AnthMendoza/ActuatorSpeedController/speed controller/.step

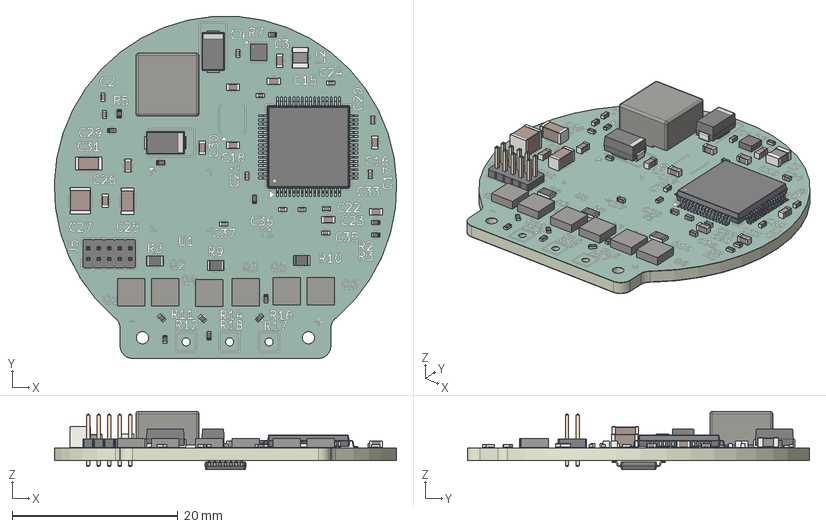
[picture p3: CAD file, 2026-11-07]
speed controller/.step
41.3 x 41.2 x 7.03 mm
C_0402_1005Metric x 13
C_1206_3216Metric x 2
C_0603_1608Metric x 10
R_0805_2012Metric x 3
WSON_8_1EP_2x2mm_P05mm_EP09x16mm
R_0402_1005Metric x 13
D_SMA x 2
L_1008_2520Metric
LQFP-64_10x10mm_P0.5mm
C_1210_3225Metric
PinHeader_2x05_P127mm_Vertical
TSSOP-14_4.4x5mm_P0.65mm
speed controller-unsaved-export-xcZnCC_silkscreen x 2
speed controller-unsaved-export-xcZnCC_soldermask x 2
speed controller-unsaved-export-xcZnCC_PCB
