AnthMendoza/ActuatorSpeedController/speed controller.pdf

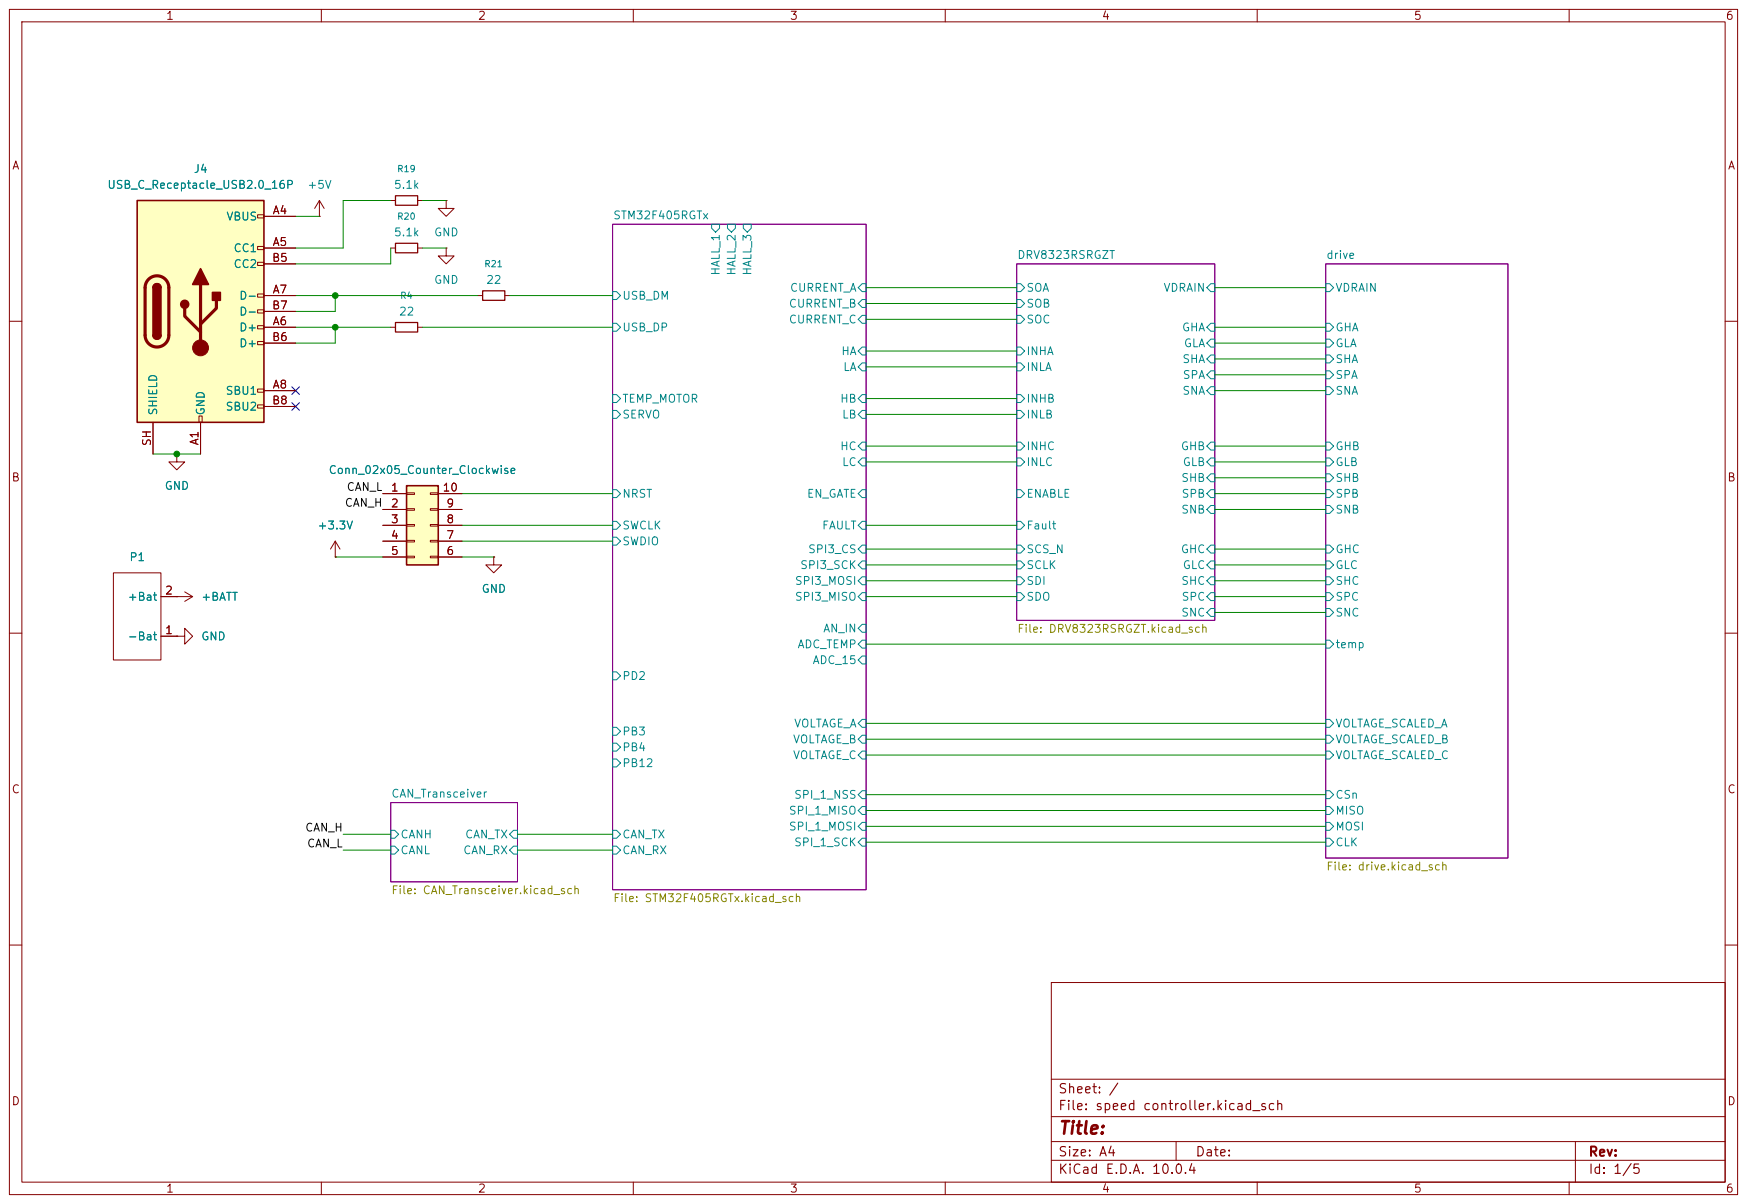
[picture p4: page 1]

VDRAIN
CSn MISO MOSI GHA GHB
GLA GLB
SHA SHB
SPA SPB
SNA SNB

Size: A4 | Rev:
KiCad E.D.A. 10.0.4 | Id: 1/5

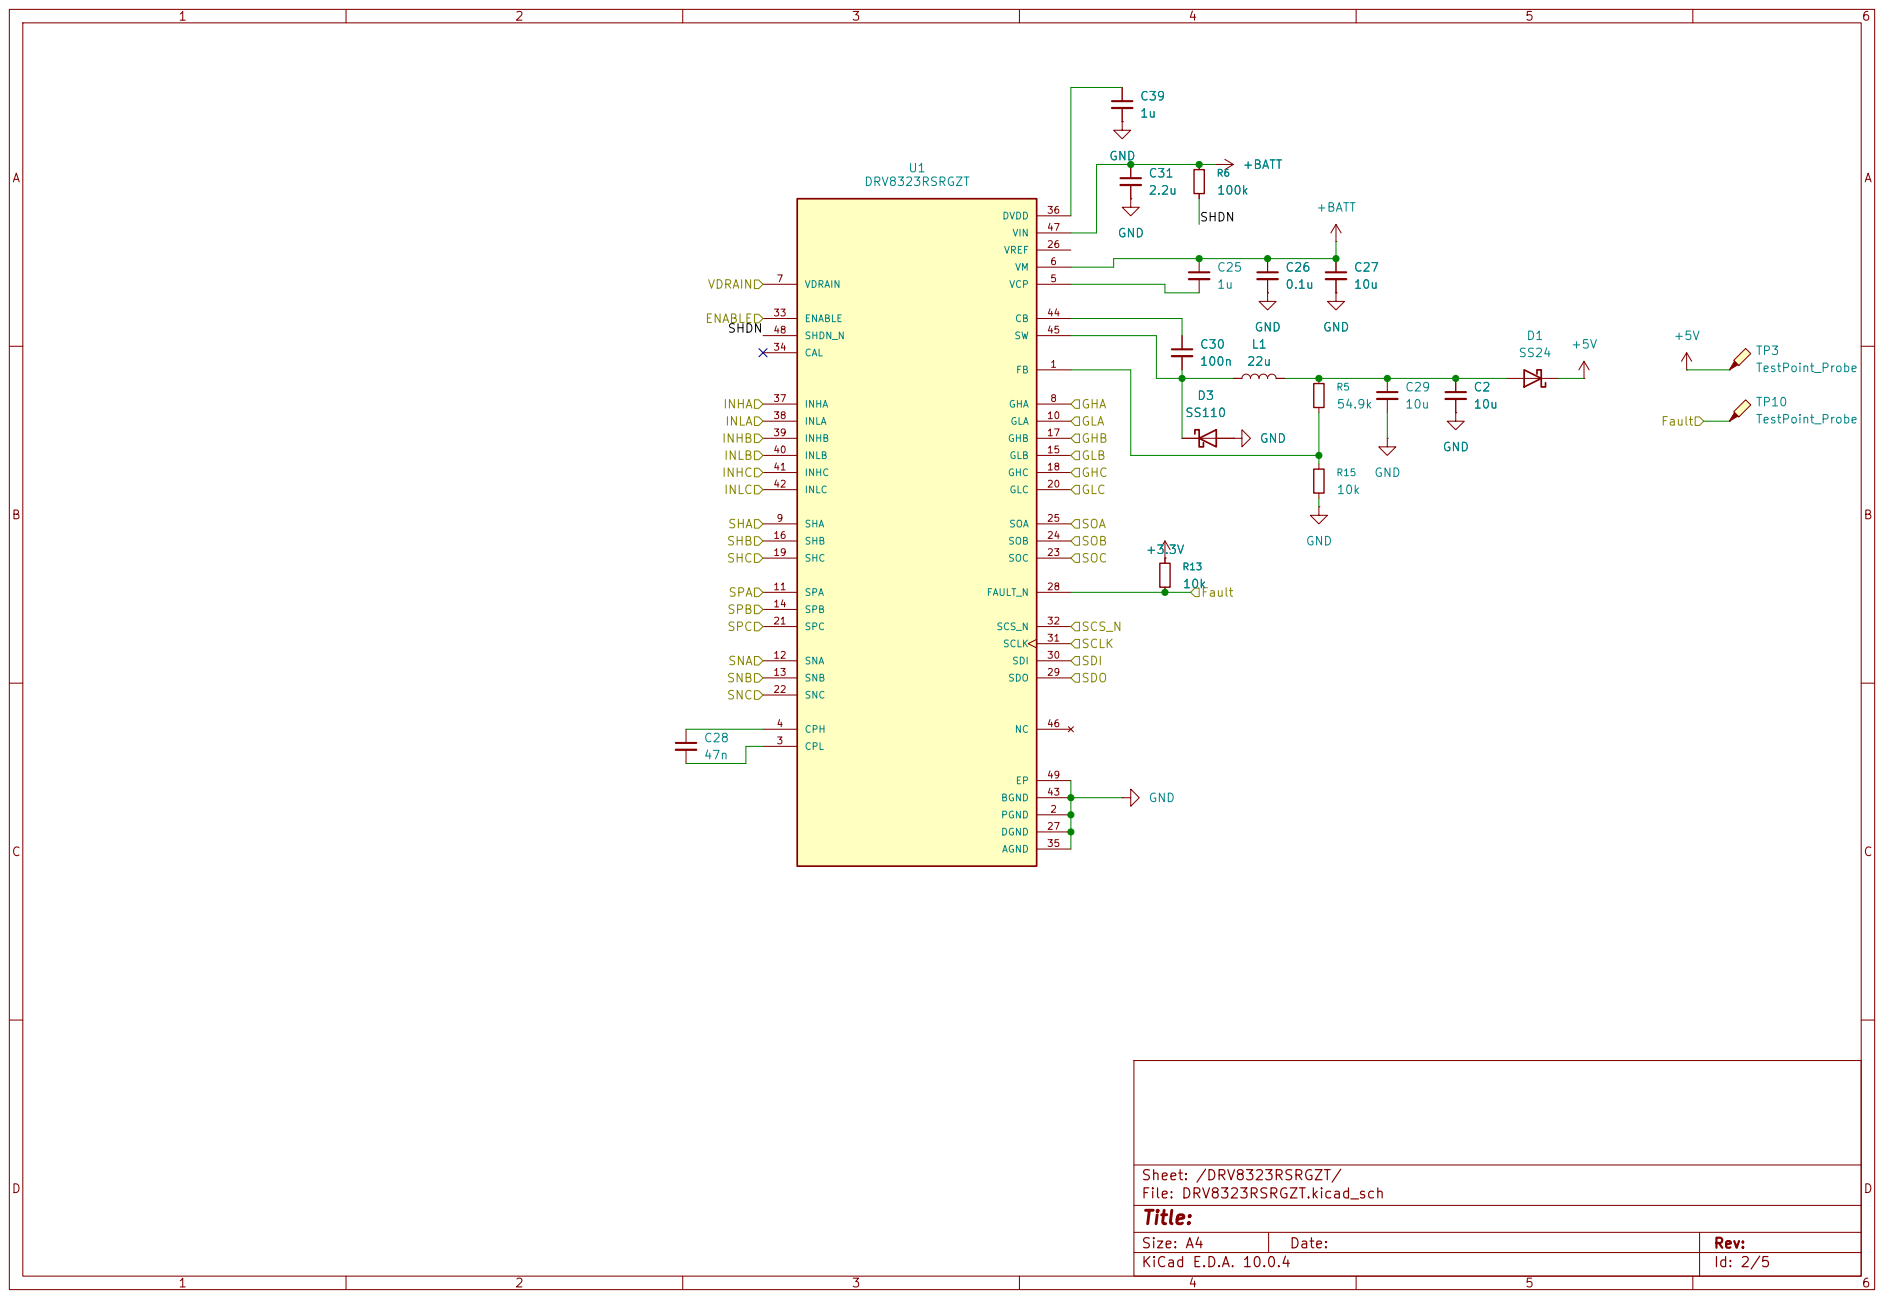
[picture p5: page 2]

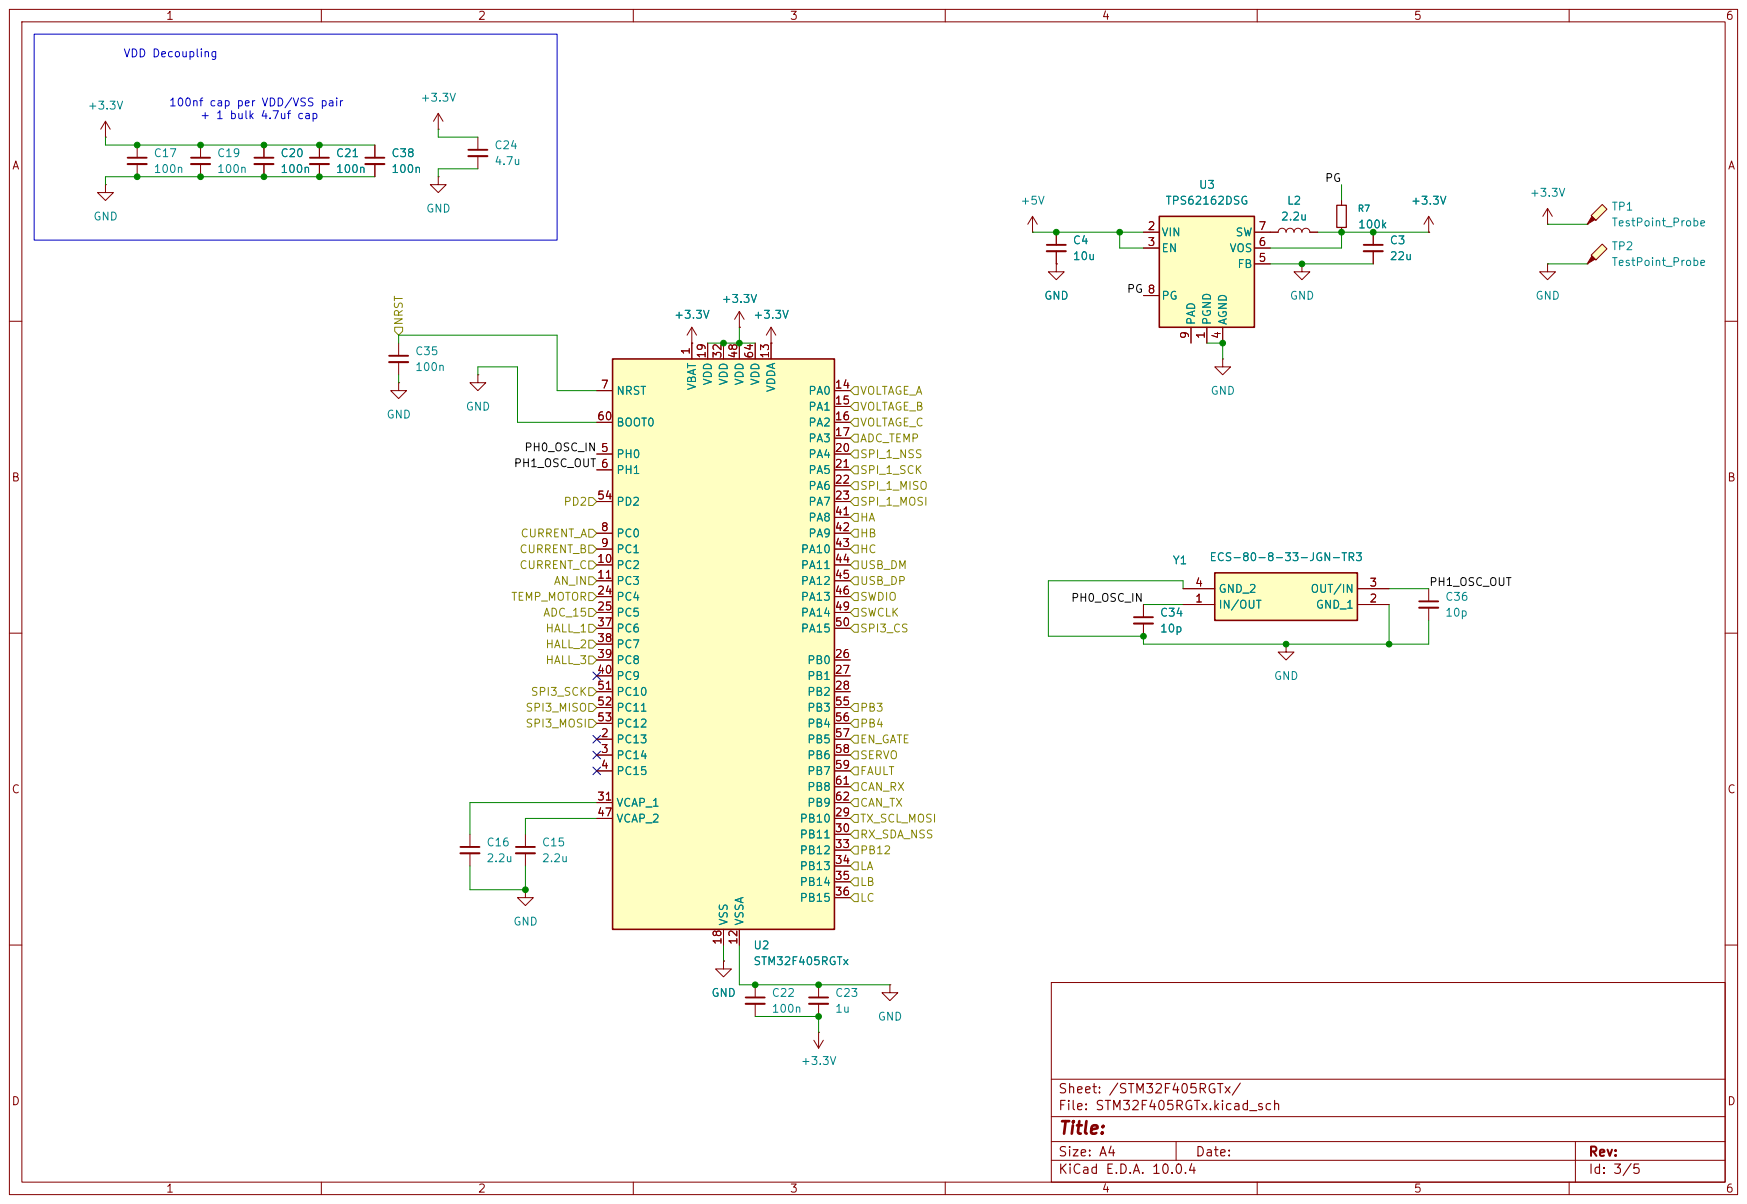
[picture p6: page 3]

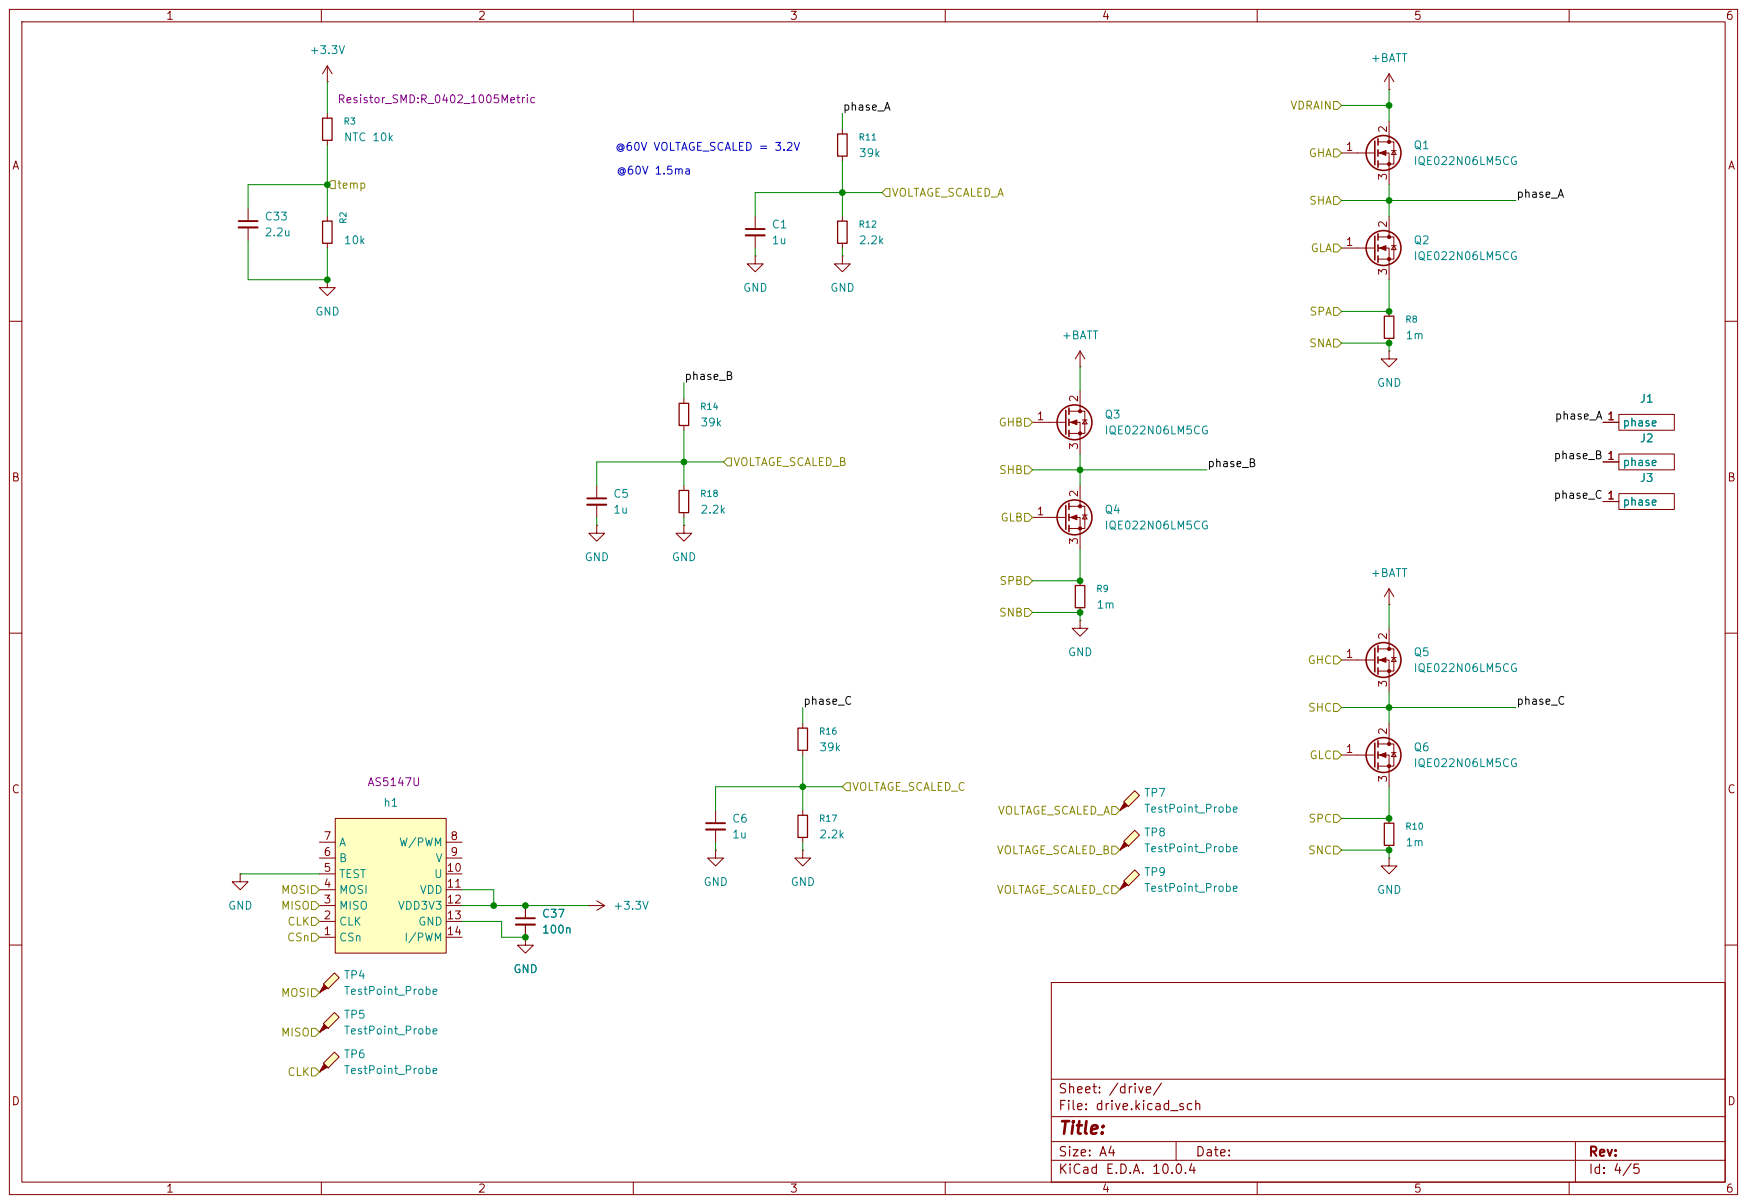
[picture p7: page 4]

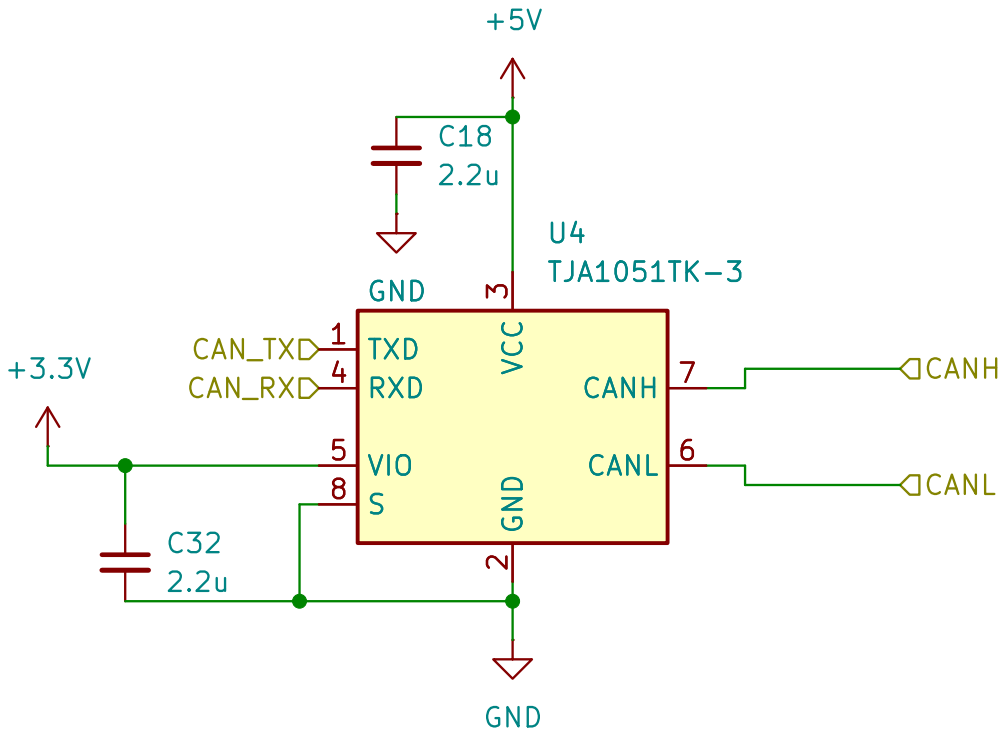
[picture p8: page 5]
