AnthMendoza/ActuatorSpeedController/speed controller/speed controller.pdf

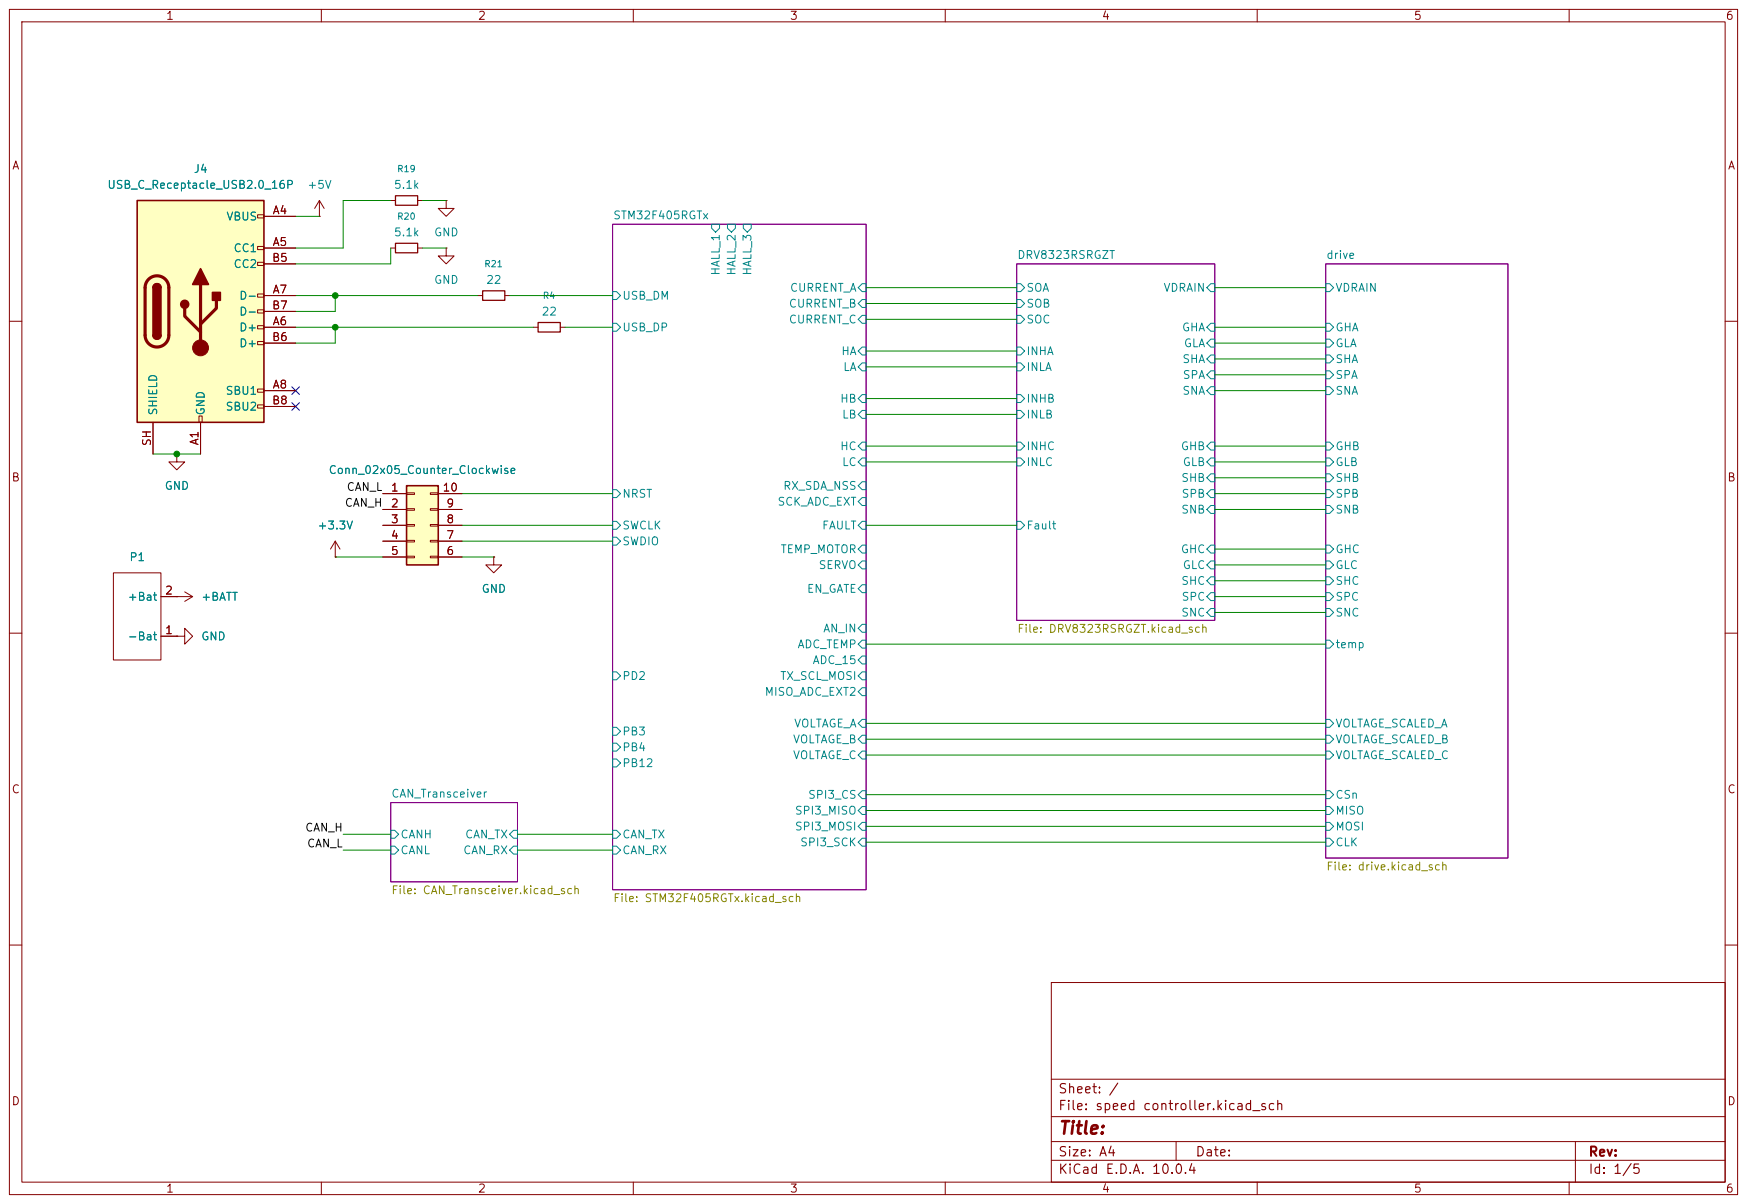
[picture p9: page 1]

VDRAIN
CSn MISO MOSI GHA GHB
GLA GLB
SHA SHB
SPA SPB
SNA SNB

Size: A4 | Rev:
KiCad E.D.A. 10.0.4 | Id: 1/5

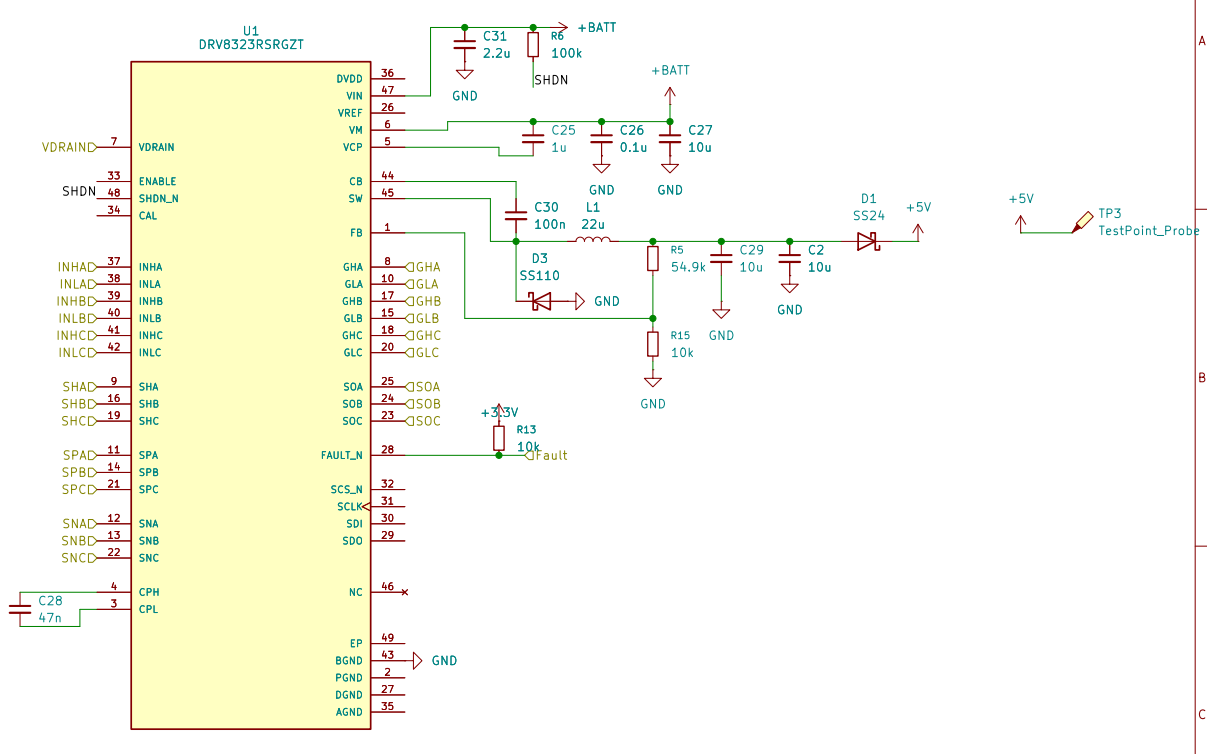
[picture p10: page 2]

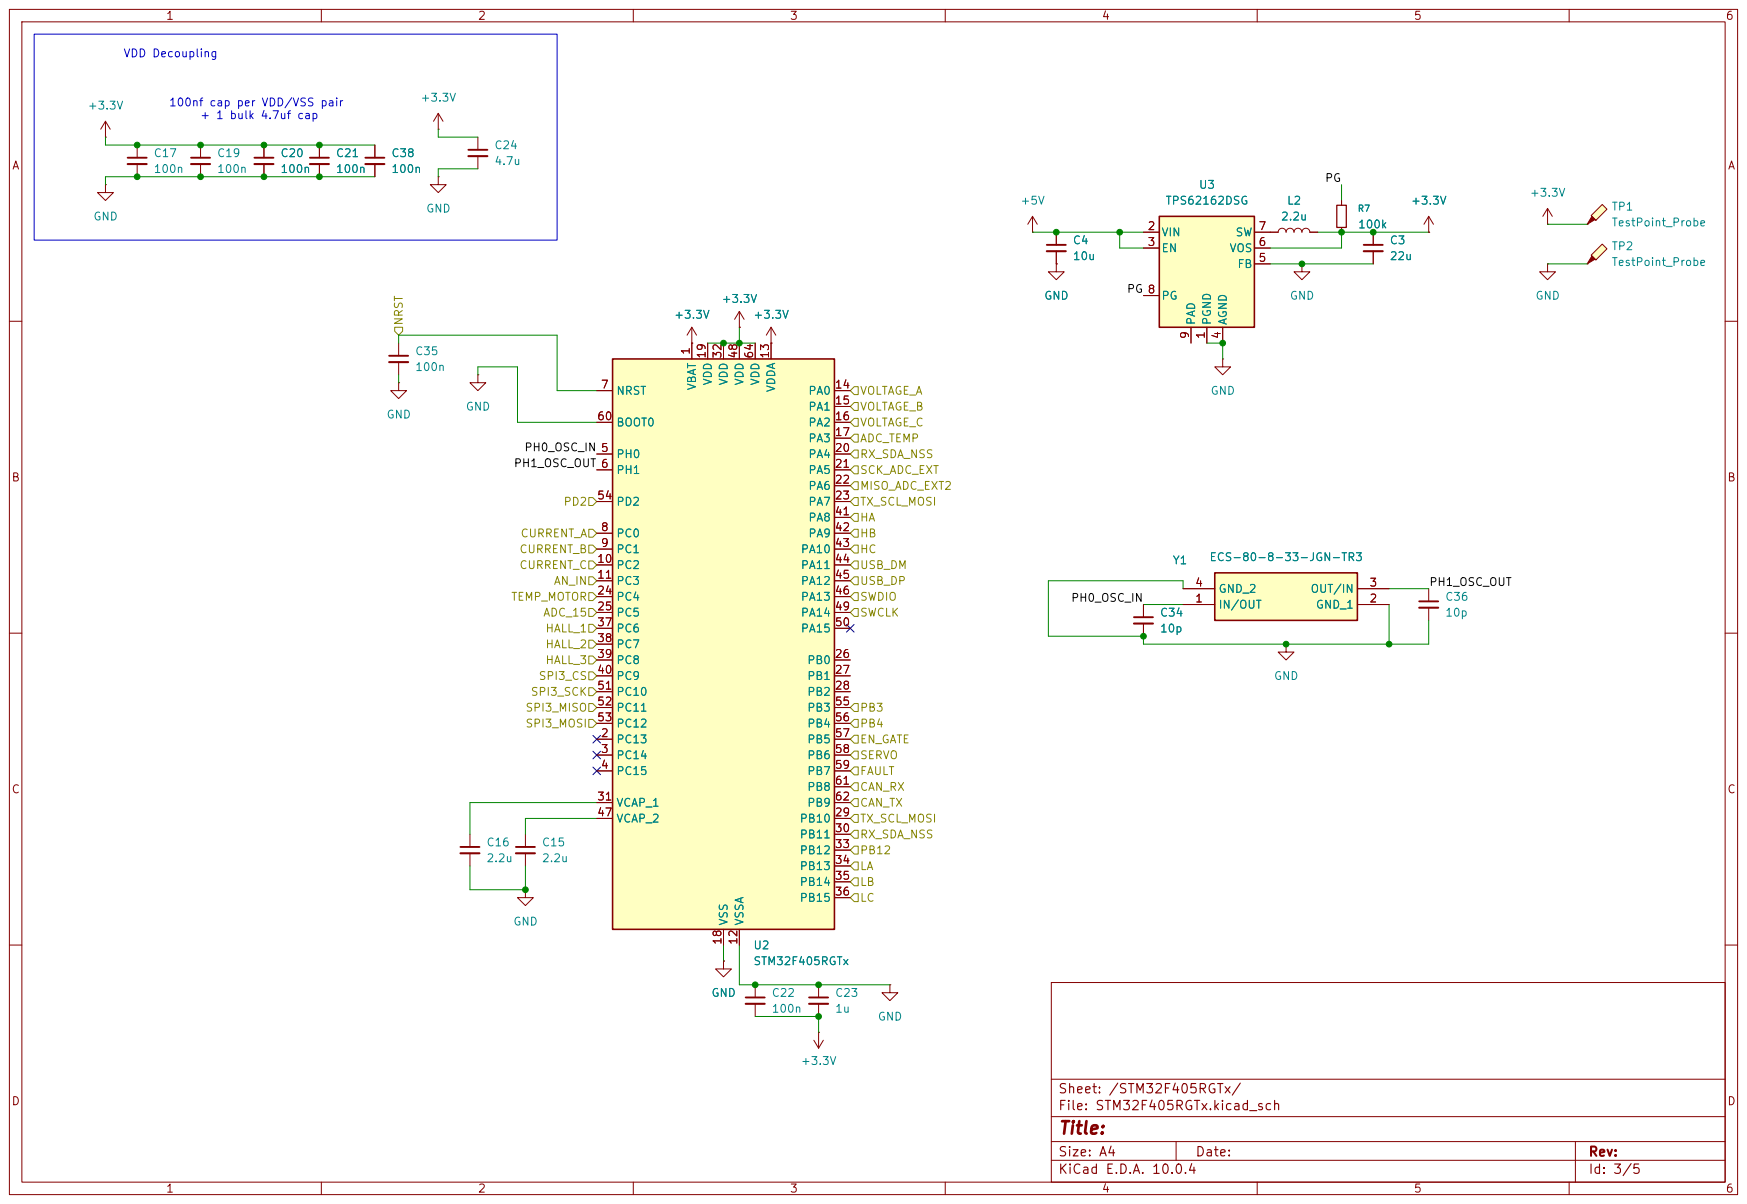
[picture p11: page 3]

PH1_OSC_OUT VDD Decoupling 100nf cap per VDD/VSS pair + 1 bulk 4.7uf cap


SPA GLA MOSI MISO
