AnthMendoza/ActuatorSpeedController/speed controller/speed controller.kicad_pcb

## KiCad design speed controller/speed controller.kicad_pcb (2026-11-14)

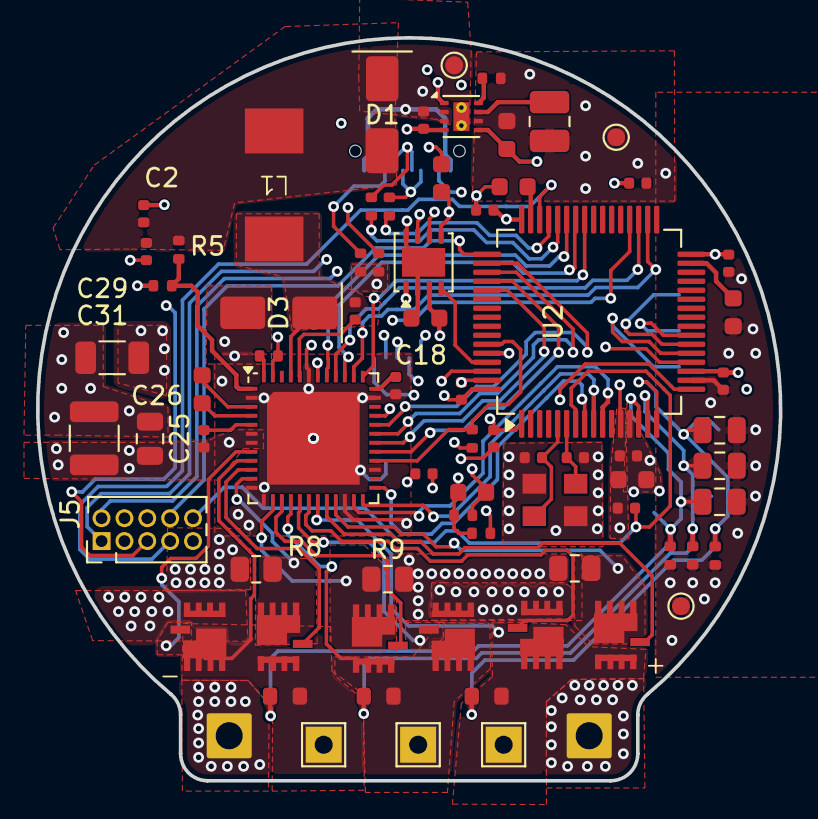
[picture p12: board speed controller.kicad_pcb from above]

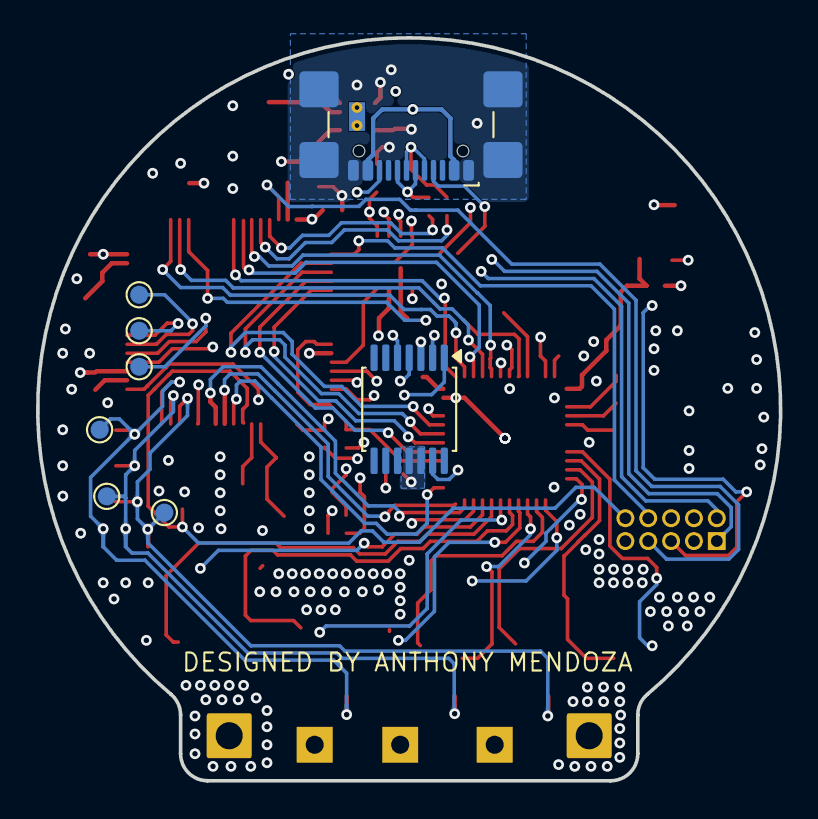
[picture p13: board speed controller.kicad_pcb from below]

Board: 4 copper layers, 41.3 x 41.3 mm, 82 parts (8 on the bottom side), 66 nets.

Parts:
C1, C5, C6: 1u; C_0805_2012Metric
C2, C4, C29: 10u; C_0402_1005Metric
C3: 22u; C_0603_1608Metric
C15, C16, C18, C32, C33: 2.2u; C_0603_1608Metric
C17, C19, C20, C21, C22, C30, C35, C37, C38: 100n; C_0402_1005Metric
C23: 1u; C_0603_1608Metric
C24: 4.7u; C_0402_1005Metric
C25, C39: 1u; C_0402_1005Metric
C26: 0.1u; C_0805_2012Metric
C27: 10u; C_1210_3225Metric
C28: 47n; C_0603_1608Metric
C31: 2.2u; C_1206_3216Metric
C34, C36: 10p; C_0402_1005Metric
D1: SS24; D_SMA
D3: SS110; D_SMA
J1, J2, J3: TestPoint_THTPad_2.0x2.0mm_Drill1.0mm
J4: USB_C_Receptacle_USB2.0_16P; USB_C_Receptacle_GCT_USB4110
J5: Conn_02x05_Counter_Clockwise; PinHeader_2x05_P1.27mm_Vertical
L1: 22u; DR74
L2: 2.2u; L_1008_2520Metric
P1: Power Pads
Q1, Q2, Q3, Q4, Q5, Q6: IQE022N06LM5CG; PG-TTFN-9-3
R2, R13, R15: 10k; R_0402_1005Metric
R3: NTC 10k; R_0402_1005Metric
R4, R21: 22; R_0402_1005Metric
R5: 54.9k; R_0402_1005Metric
R6, R7: 100k; R_0402_1005Metric
R8, R9, R10: 1m; R_0805_2012Metric
R11, R14, R16: 39k; R_0603_1608Metric
R12, R17, R18: 2.2k; R_0402_1005Metric
R19, R20: 5.1k; R_0402_1005Metric
TP1, TP2, TP3, TP4, TP5, TP6, TP7, TP8, TP9: TestPoint_Probe; TestPoint_Pad_D1.0mm
U1: DRV8323RSRGZT; Infineon_MLPQ-48-1EP_7x7mm_P0.5mm_EP5.15x5.15mm
U2: STM32F405RGTx; LQFP-64_10x10mm_P0.5mm
U3: TPS62162DSG; WSON-8-1EP_2x2mm_P0.5mm_EP0.9x1.6mm_ThermalVias
U4: TJA1051TK-3; HVSON-8-1EP_3x3mm_P0.65mm_EP1.6x2.4mm
Y1: ECS-80-8-33-JGN-TR3
h1: TSSOP-14_4.4x5mm_P0.65mm

Connections:
+3.3V: C3.1, C17.1, C19.1, C20.1, C21.1, C22.2, C23.2, C24.1, C32.1, C37.1, C38.1, J5.5, L2.2, R3.1, R7.2, R13.1, TP1.1 (1_1), U2.1 (VBAT), U2.13 (VDDA), U2.19 (VDD), U2.32 (VDD), U2.48 (VDD), U2.64 (VDD), U3.6 (VOS), U4.5 (VIO), h1.11 (VDD), h1.12 (VDD3V3)
+5V: C4.1, C18.1, D1.1 (K), J4.A4 (VBUS), J4.A9 (VBUS), J4.B4 (VBUS), J4.B9 (VBUS), TP3.1 (1_1), U3.2 (VIN), U3.3 (EN), U4.3 (VCC)
+BATT: C25.1, C26.1, C27.1, C31.1, P1.2 (+Bat), Q1.2 (D), Q3.2 (D), Q5.2 (D), R6.1, U1.6 (VM), U1.7 (VDRAIN), U1.47 (VIN)
/CAN_H: J5.2, U4.7 (CANH)
/CAN_L: J5.1, U4.6 (CANL)
/CAN_Transceiver/CAN_RX: U2.61 (PB8), U4.4 (RXD)
/CAN_Transceiver/CAN_TX: U2.62 (PB9), U4.1 (TXD)
/DRV8323RSRGZT/Fault: R13.2, U1.28 (FAULT_N), U2.59 (PB7)
/DRV8323RSRGZT/GHA: Q1.1 (G), U1.8 (GHA)
/DRV8323RSRGZT/GHB: Q3.1 (G), U1.17 (GHB)
/DRV8323RSRGZT/GHC: Q5.1 (G), U1.18 (GHC)
/DRV8323RSRGZT/GLA: Q2.1 (G), U1.10 (GLA)
/DRV8323RSRGZT/GLB: Q4.1 (G), U1.15 (GLB)
/DRV8323RSRGZT/GLC: Q6.1 (G), U1.20 (GLC)
/DRV8323RSRGZT/INHA: U1.37 (INHA), U2.41 (PA8)
/DRV8323RSRGZT/INHB: U1.39 (INHB), U2.42 (PA9)
/DRV8323RSRGZT/INHC: U1.41 (INHC), U2.43 (PA10)
/DRV8323RSRGZT/INLA: U1.38 (INLA), U2.34 (PB13)
/DRV8323RSRGZT/INLB: U1.40 (INLB), U2.35 (PB14)
/DRV8323RSRGZT/INLC: U1.42 (INLC), U2.36 (PB15)
/DRV8323RSRGZT/SCLK: U1.31 (SCLK), U2.51 (PC10)
/DRV8323RSRGZT/SCS_N: U1.32 (SCS_N), U2.50 (PA15)
/DRV8323RSRGZT/SDI: U1.30 (SDI), U2.53 (PC12)
/DRV8323RSRGZT/SDO: U1.29 (SDO), U2.52 (PC11)
/DRV8323RSRGZT/SHDN: R6.2, U1.48 (SHDN_N)
/DRV8323RSRGZT/SOA: U1.25 (SOA), U2.8 (PC0)
/DRV8323RSRGZT/SOB: U1.24 (SOB), U2.9 (PC1)
/DRV8323RSRGZT/SOC: U1.23 (SOC), U2.10 (PC2)
/DRV8323RSRGZT/SPA: Q2.3 (S), R8.1, U1.11 (SPA)
/DRV8323RSRGZT/SPB: Q4.3 (S), R9.1, U1.14 (SPB)
/DRV8323RSRGZT/SPC: Q6.3 (S), R10.1, U1.21 (SPC)
/STM32F405RGTx/ADC_TEMP: C33.1, R2.1, R3.2, U2.17 (PA3)
/STM32F405RGTx/NRST: C35.1, J5.10, U2.7 (NRST)
/STM32F405RGTx/PG: R7.1, U3.8 (PG)
/STM32F405RGTx/PH0_OSC_IN: C34.1, U2.5 (PH0), Y1.1 (IN/OUT)
/STM32F405RGTx/PH1_OSC_OUT: C36.1, U2.6 (PH1), Y1.3 (OUT/IN)
/STM32F405RGTx/SPI_1_MISO: TP5.1 (1_1), U2.22 (PA6), h1.3 (MISO)
/STM32F405RGTx/SPI_1_MOSI: TP4.1 (1_1), U2.23 (PA7), h1.4 (MOSI)
/STM32F405RGTx/SPI_1_NSS: U2.20 (PA4), h1.1 (CSn)
/STM32F405RGTx/SPI_1_SCK: TP6.1 (1_1), U2.21 (PA5), h1.2 (CLK)
/STM32F405RGTx/SWCLK: J5.8, U2.49 (PA14)
/STM32F405RGTx/SWDIO: J5.7, U2.46 (PA13)
/STM32F405RGTx/USB_DM: R21.2, U2.44 (PA11)
/STM32F405RGTx/USB_DP: R4.2, U2.45 (PA12)
/STM32F405RGTx/VOLTAGE_A: C1.1, R11.2, R12.1, TP7.1 (1_1), U2.14 (PA0)
/STM32F405RGTx/VOLTAGE_B: C5.1, R14.2, R18.1, TP8.1 (1_1), U2.15 (PA1)
/STM32F405RGTx/VOLTAGE_C: C6.1, R16.2, R17.1, TP9.1 (1_1), U2.16 (PA2)
/drive/phase_A: J1.1 (phase_1), Q1.3 (S), Q2.2 (D), R11.1, U1.9 (SHA)
/drive/phase_B: J2.1 (phase_1), Q3.3 (S), Q4.2 (D), R14.1, U1.16 (SHB)
/drive/phase_C: J3.1 (phase_1), Q5.3 (S), Q6.2 (D), R16.1, U1.19 (SHC)
GND: C1.2, C2.2, C3.2, C4.2, C5.2, C6.2, C15.2, C16.2, C17.2, C18.2, C19.2, C20.2, C21.2, C22.1, C23.1, C24.2, C26.2, C27.2, C29.2, C31.2, C32.2, C33.2, C34.2, C35.2, C36.2, C37.2, C38.2, C39.2, D3.2 (A), J4.A1 (GND), J4.A12 (GND), J4.B1 (GND), J4.B12 (GND), J4.SH (SHIELD), J5.6, P1.1 (-Bat), R2.2, R8.2, R9.2, R10.2, R12.2, R15.2, R17.2, R18.2, R19.2, R20.2, TP2.1 (1_1), U1.2 (PGND), U1.12 (SNA), U1.13 (SNB), U1.22 (SNC), U1.27 (DGND), U1.35 (AGND), U1.43 (BGND), U1.49 (EP), U2.12 (VSSA), U2.18 (VSS), U2.60 (BOOT0), U2.63 (VSS), U3.1 (PGND), U3.4 (AGND), U3.5 (FB), U4.2 (GND), U4.8 (S), U4.9 (GND), Y1.2 (GND_1), Y1.4 (GND_2), h1.5 (TEST), h1.13 (GND)
unnamed: C2.1, C29.1, D1.2 (A), L1.2, R5.1
unnamed: C30.2, D3.1 (K), L1.1, U1.45 (SW)
unnamed: J4.A5 (CC1), R19.1
unnamed: J4.B5 (CC2), R20.1
unnamed: J4.A6 (D+), J4.B6 (D+), R4.1
unnamed: J4.A7 (D-), J4.B7 (D-), R21.1
unnamed: C30.1, U1.44 (CB)
unnamed: C28.1, U1.4 (CPH)
unnamed: C28.2, U1.3 (CPL)
unnamed: C39.1, U1.36 (DVDD)
unnamed: R5.2, R15.1, U1.1 (FB)
unnamed: C25.2, U1.5 (VCP)
unnamed: C16.1, U2.31 (VCAP_1)
unnamed: C15.1, U2.47 (VCAP_2)
unnamed: L2.1, U3.7 (SW)
