AnthMendoza/ActuatorSpeedController/(commit log)

2026-09-16 inital commit
    [CAN_Transceiver.kicad_sch, DRV8323RSRGZT.kicad_sch, STM32F405RGTx.kicad_sch, drive.kicad_sch, half_bridges.kicad_sch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]
2026-10-23 inital board layout
2026-10-25 design rules JLCPCB, and started trace routing
2026-10-26 trace routing. needs more work on 5v bus. prelem layout complete
2026-11-07 improvments in routing and power distrabution, prep for MFG
2026-11-14 SPI pin changes to align with readMe
